jjiiaannhi3-byte/FALL-LINE/Process photos/7.jpg

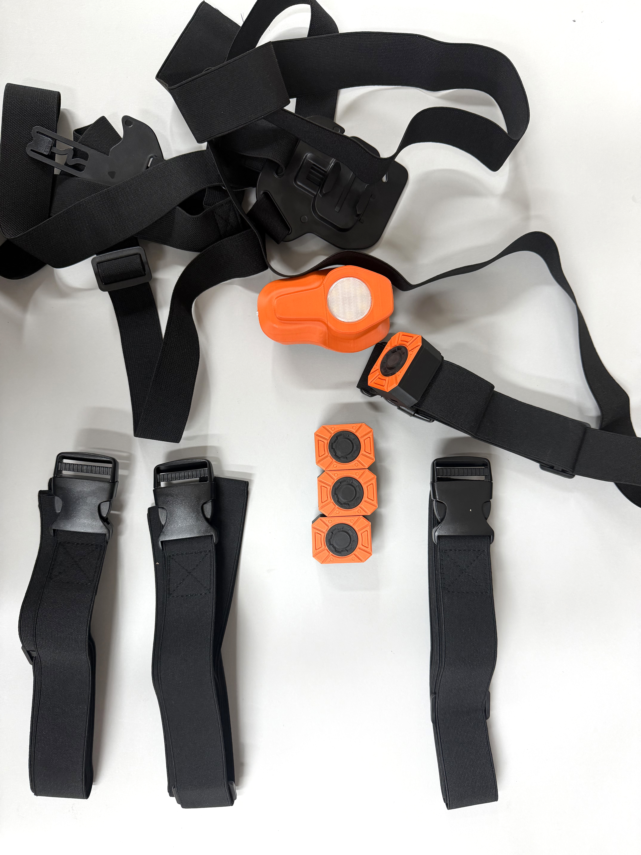
Process photos/7.jpg
