jjiiaannhi3-byte/FALL-LINE/Process photos/3.jpg

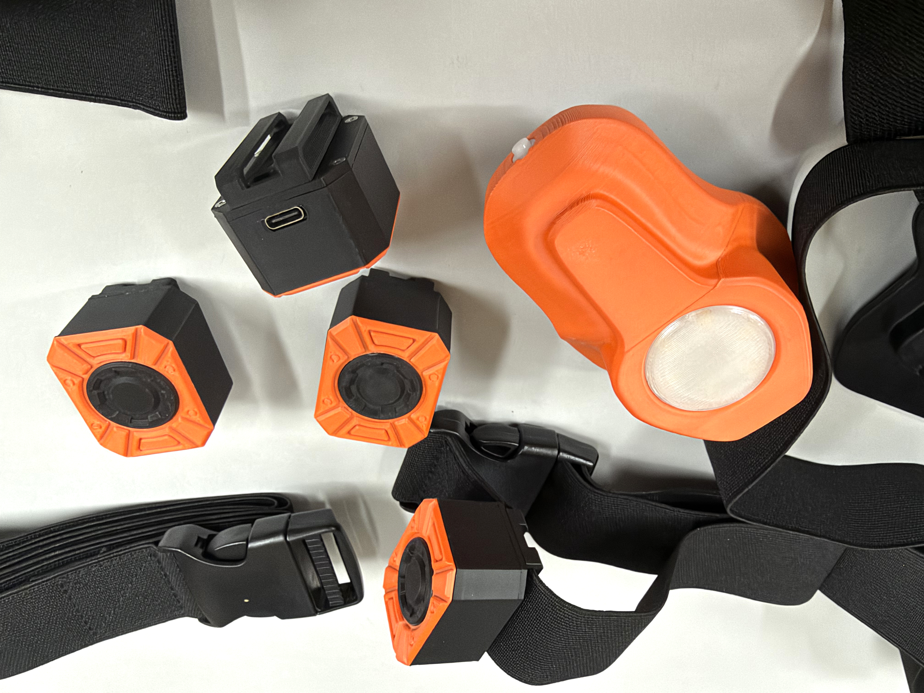
Process photos/3.jpg
