jjiiaannhi3-byte/FALL-LINE/Process photos/1.jpg

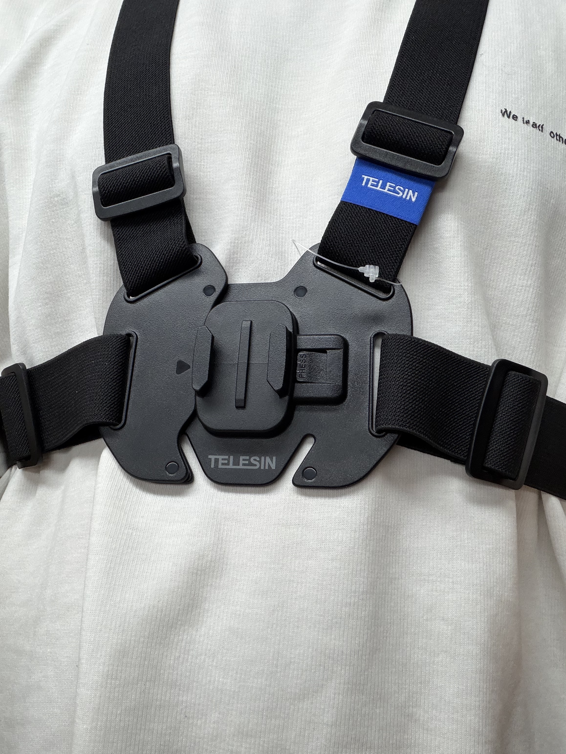
Process photos/1.jpg
