jjiiaannhi3-byte/FALL-LINE/Process photos/2.jpg

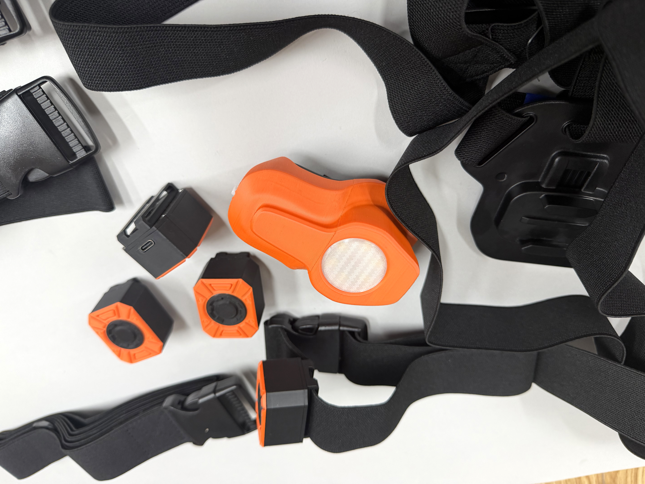
Process photos/2.jpg
