jjiiaannhi3-byte/FALL-LINE/Process photos/5.jpg

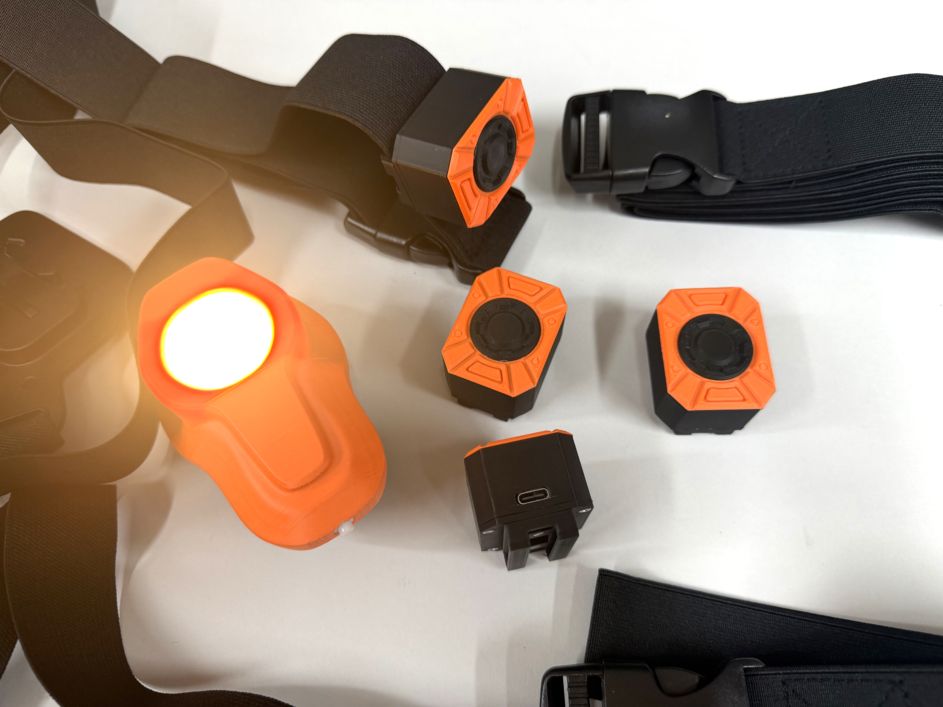
Process photos/5.jpg
