jjiiaannhi3-byte/FALL-LINE/Process photos/6.jpg

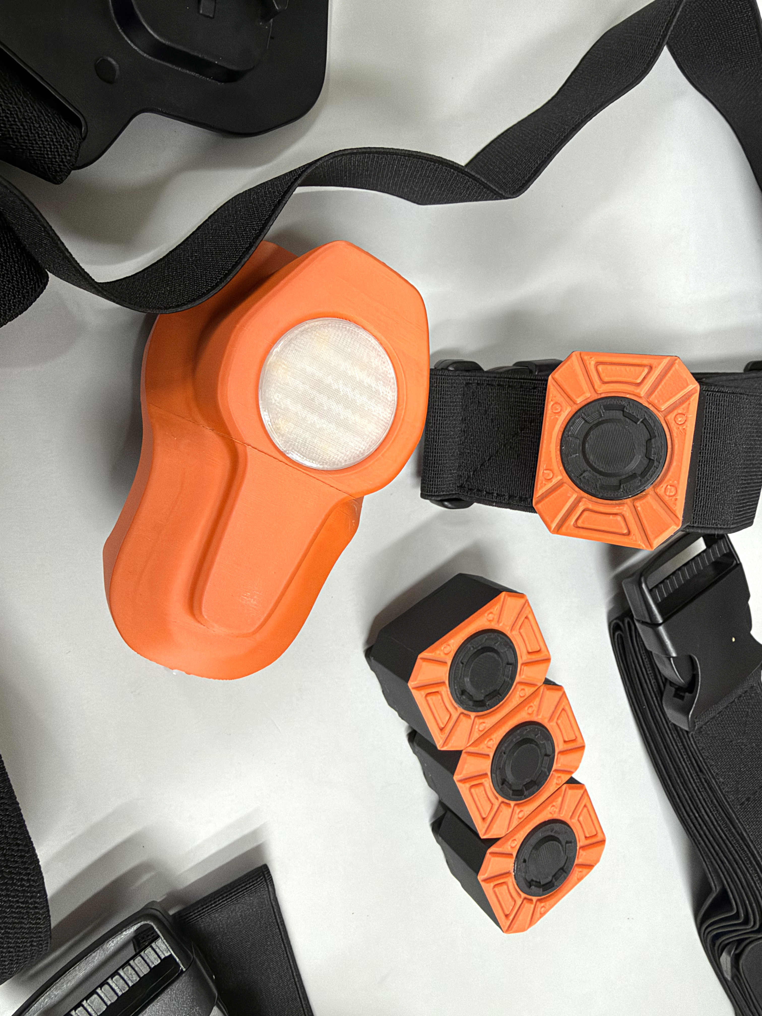
Process photos/6.jpg
