jjiiaannhi3-byte/FALL-LINE/Process photos/8.jpg

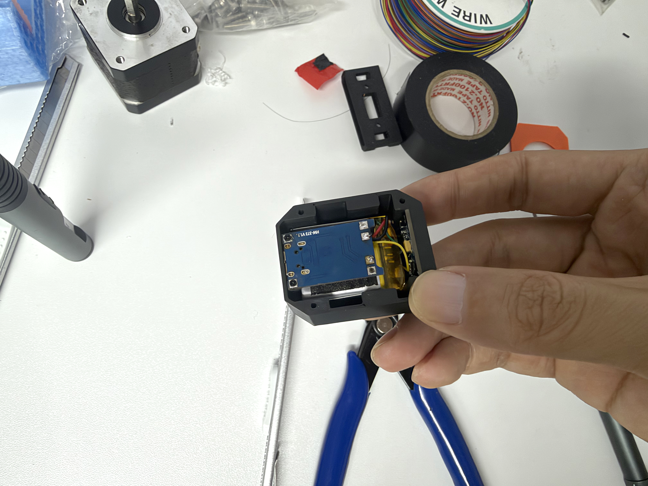
Process photos/8.jpg
