jjiiaannhi3-byte/FALL-LINE/Process photos/9.jpg

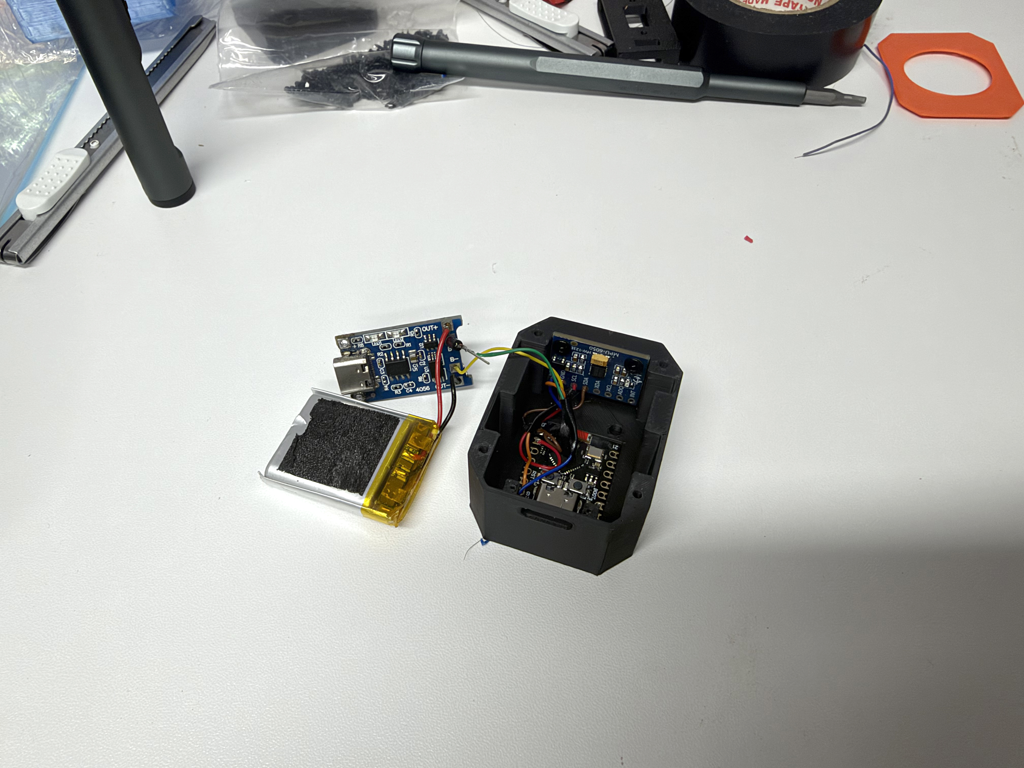
Process photos/9.jpg
