jjiiaannhi3-byte/FALL-LINE/Process photos/10.jpg

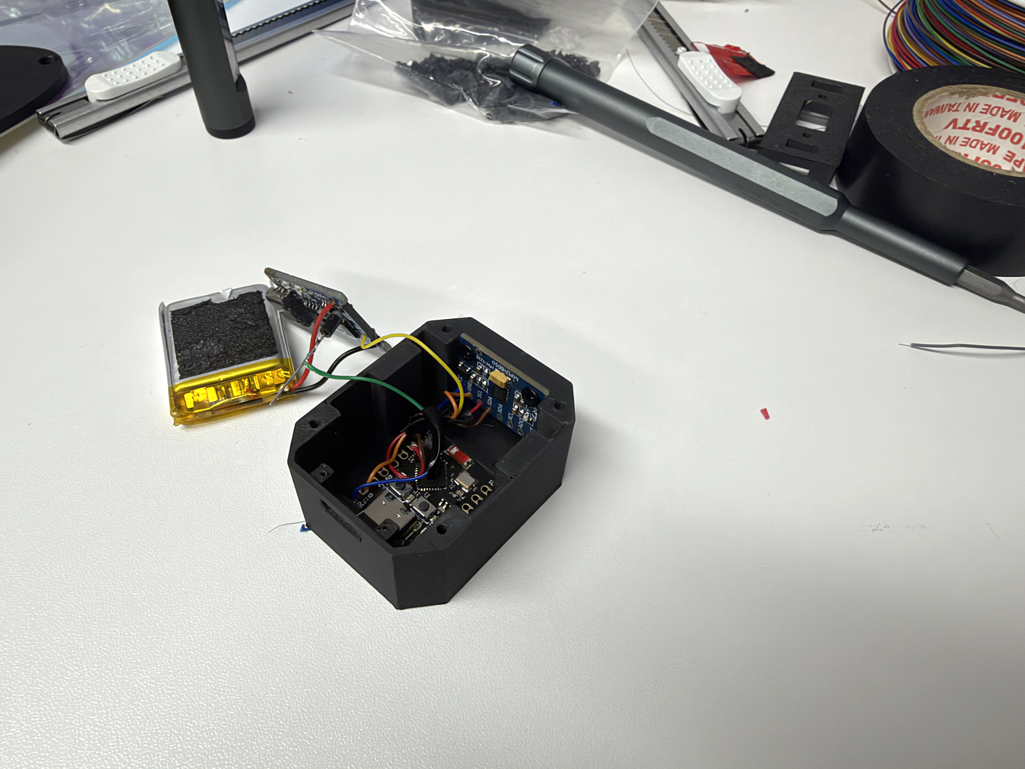
Process photos/10.jpg
