jjiiaannhi3-byte/FALL-LINE/Process photos/11.jpg

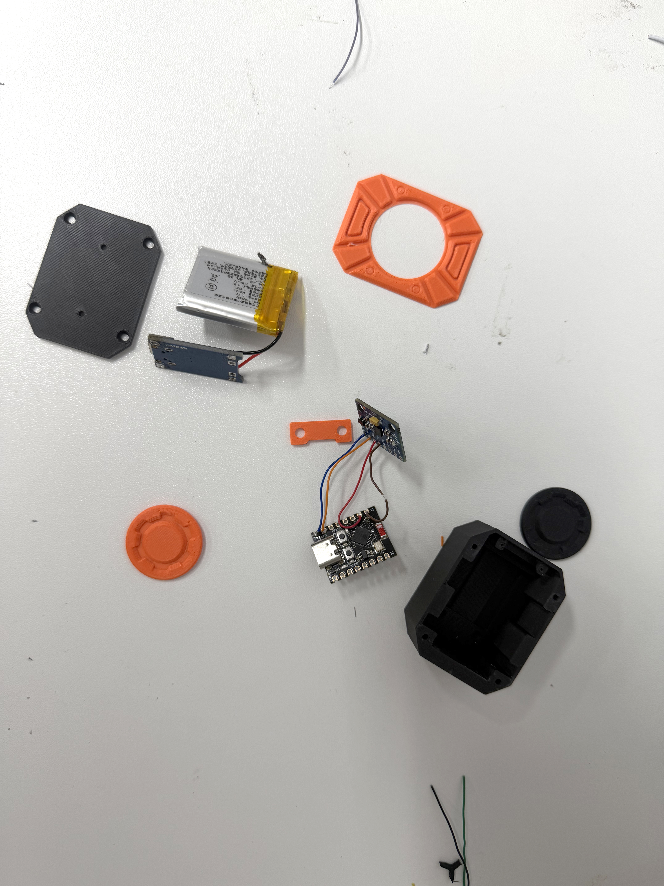
Process photos/11.jpg
