jjiiaannhi3-byte/FALL-LINE/Process photos/12.jpg

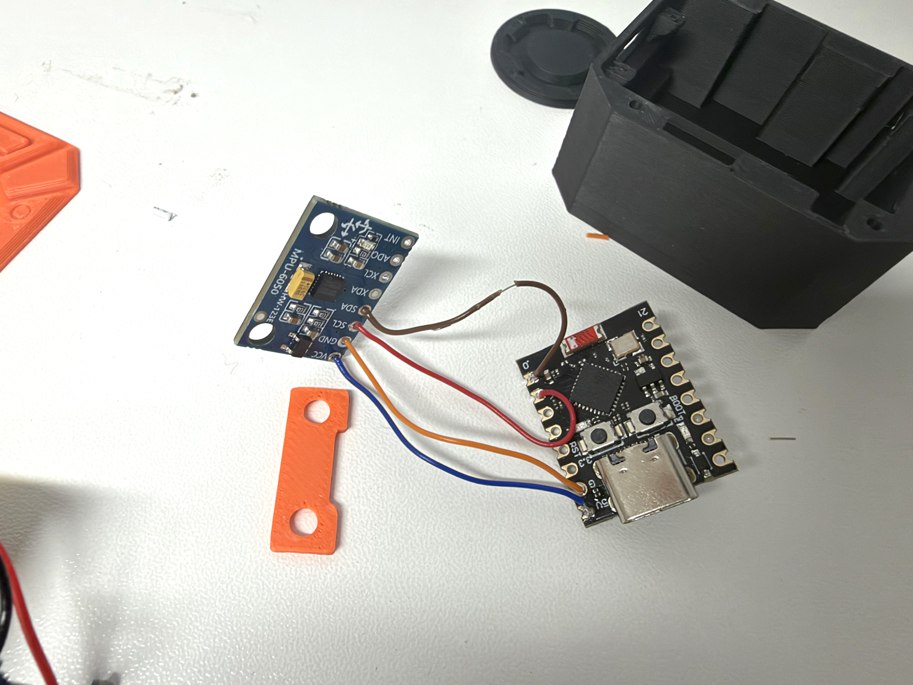
Process photos/12.jpg
