jjiiaannhi3-byte/FALL-LINE/Process photos/13.jpg

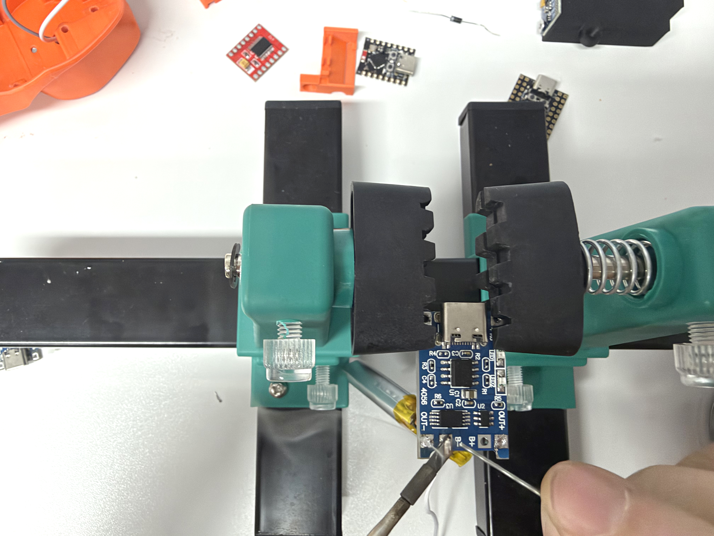
Process photos/13.jpg
