jjiiaannhi3-byte/FALL-LINE/Process photos/14.jpg

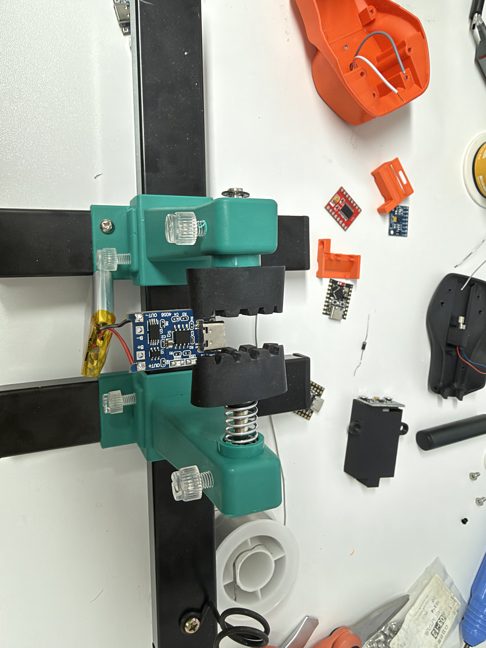
Process photos/14.jpg
