jjiiaannhi3-byte/FALL-LINE/Process photos/15.jpg

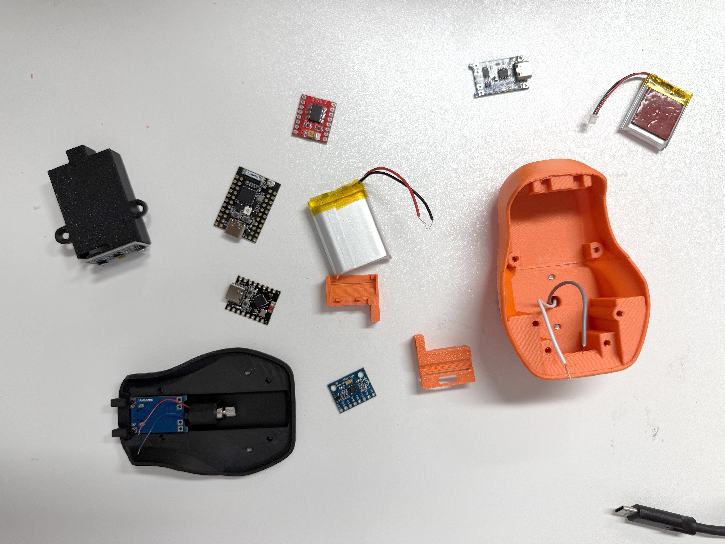
Process photos/15.jpg
