jjiiaannhi3-byte/FALL-LINE/三维建模/1.png

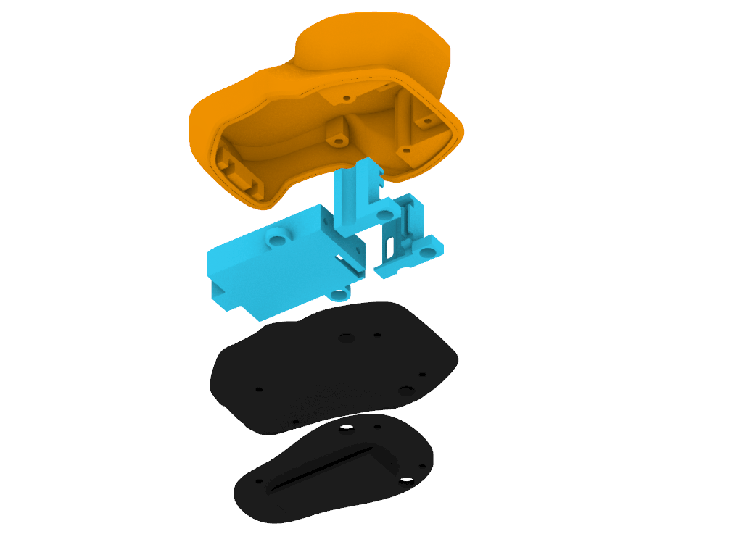
三维建模/1.png
