jjiiaannhi3-byte/FALL-LINE/三维建模/2.png

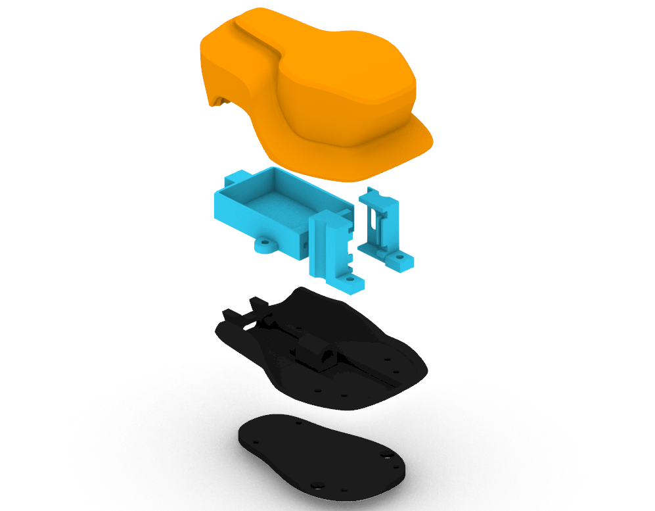
三维建模/2.png
