jjiiaannhi3-byte/FALL-LINE/三维建模/3.png

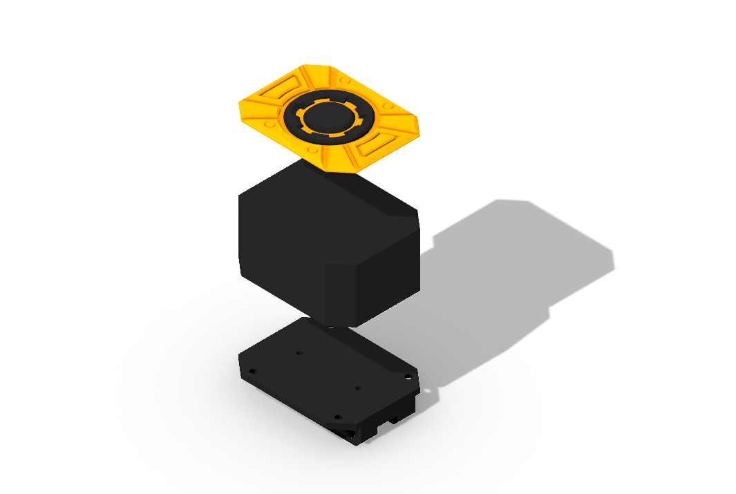
三维建模/3.png
