jjiiaannhi3-byte/FALL-LINE/三维建模/4.png

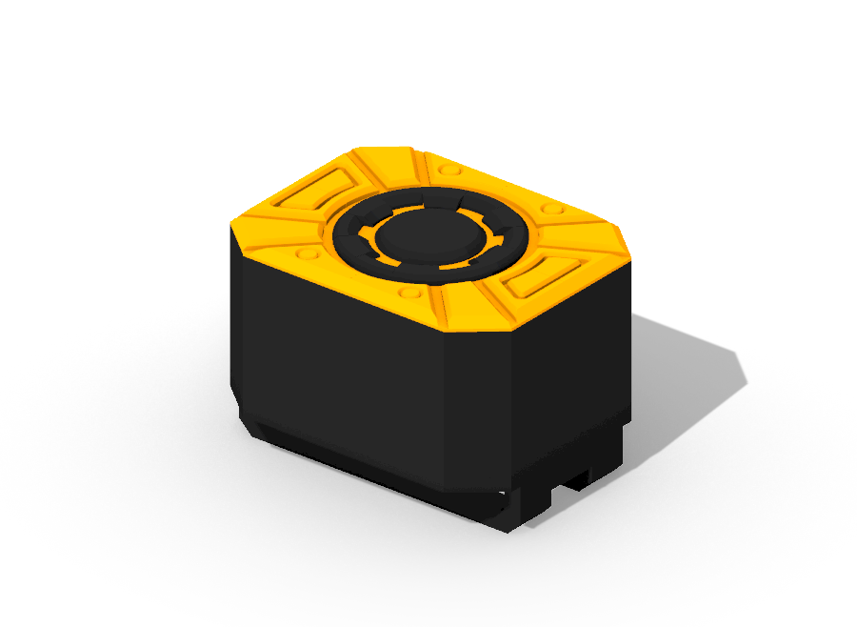
三维建模/4.png
