jjiiaannhi3-byte/FALL-LINE/三维建模/5.png

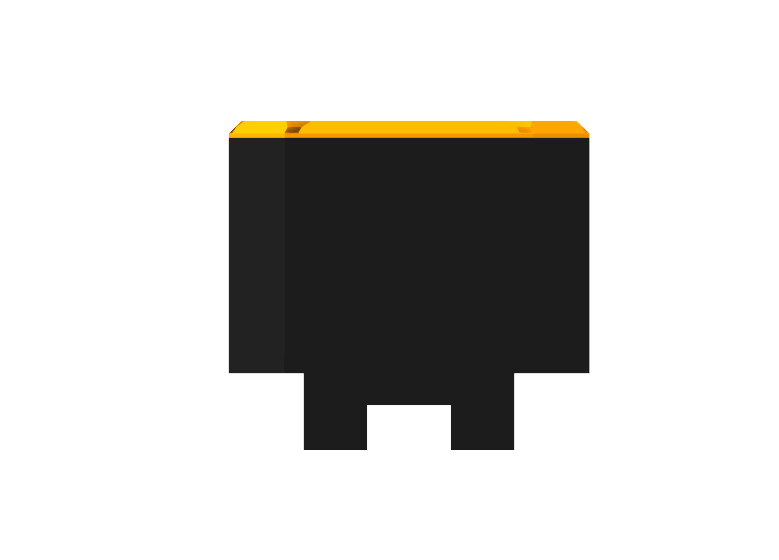
三维建模/5.png
