jjiiaannhi3-byte/FALL-LINE/三维建模/6.png

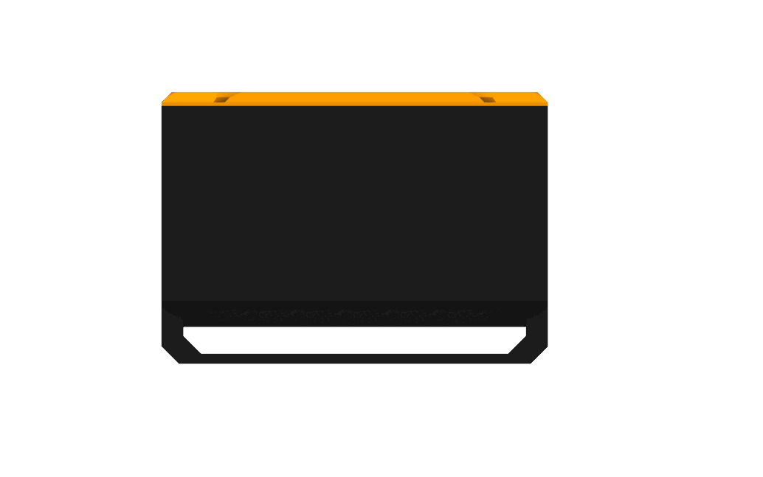
三维建模/6.png
