jjiiaannhi3-byte/FALL-LINE/三维建模/7.png

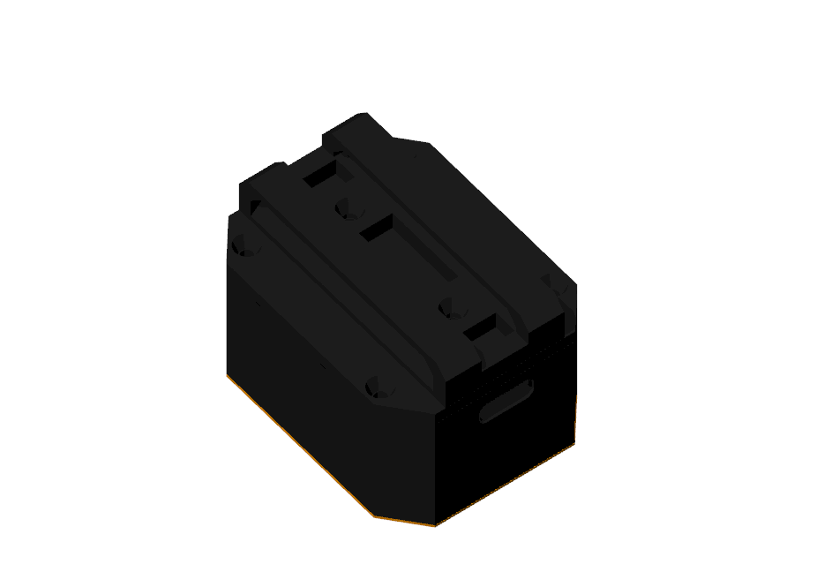
三维建模/7.png
