jjiiaannhi3-byte/FALL-LINE/三维建模/8.png

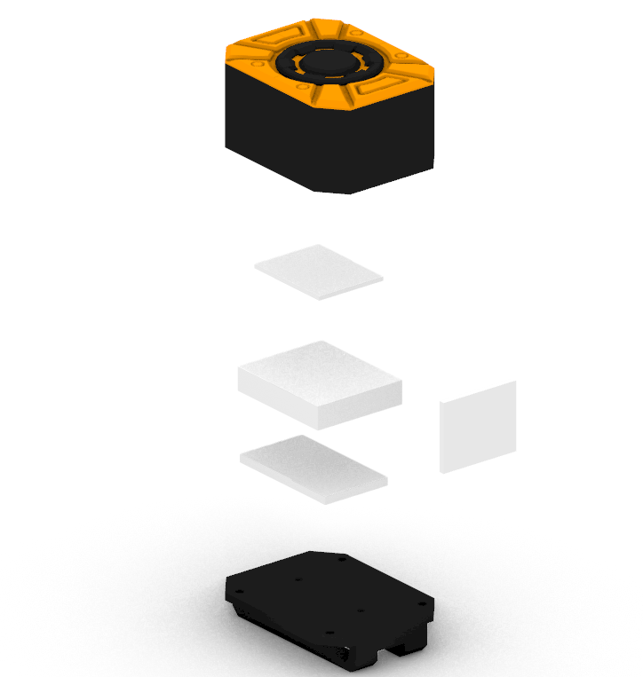
三维建模/8.png
