jjiiaannhi3-byte/FALL-LINE/三维建模/9.png

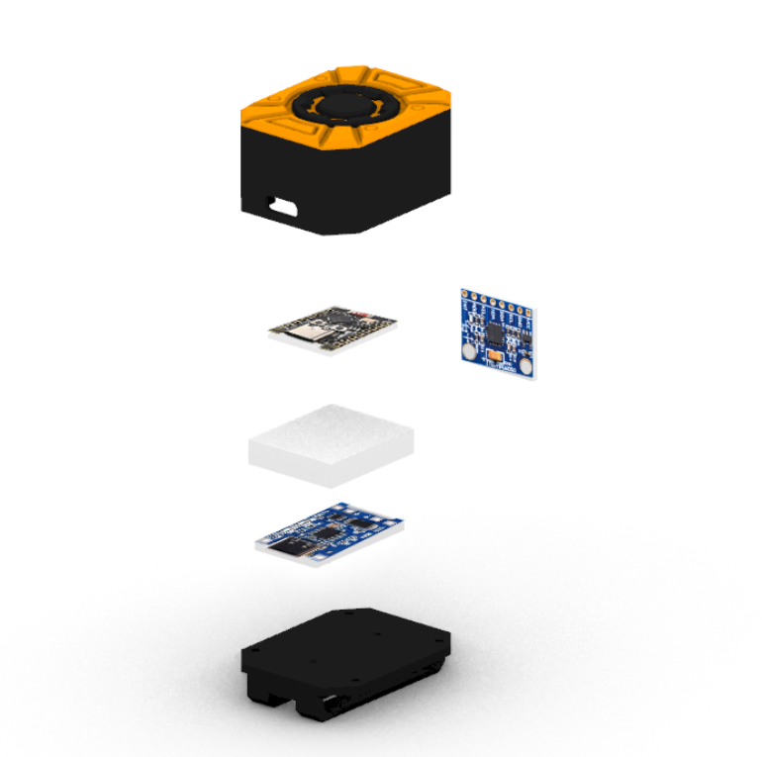
三维建模/9.png
