jjiiaannhi3-byte/FALL-LINE/三维建模/10.jpg

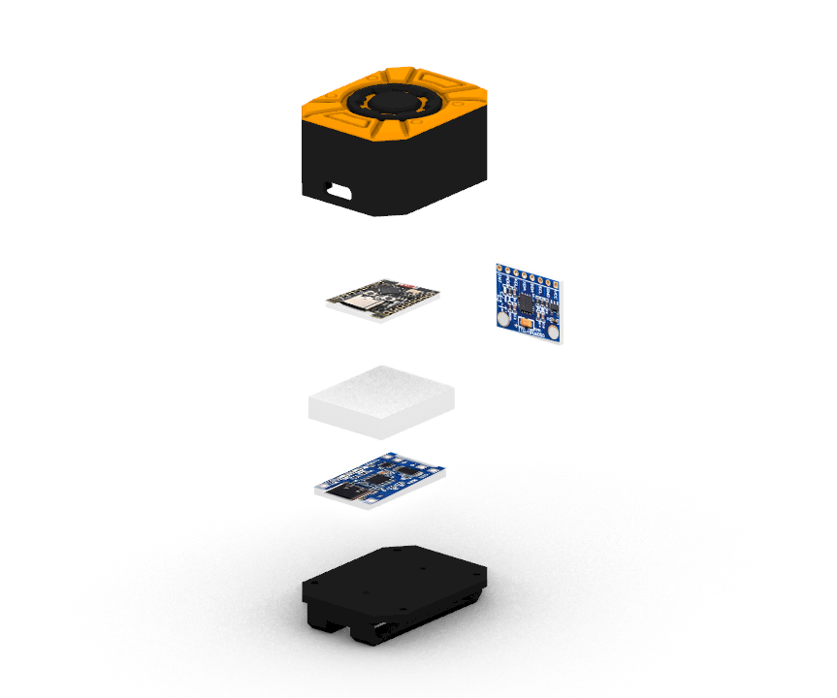
三维建模/10.jpg
