jjiiaannhi3-byte/FALL-LINE/三维建模/11.jpg

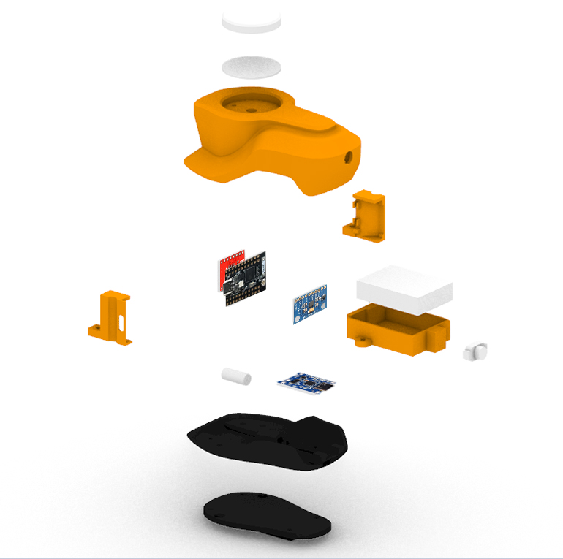
三维建模/11.jpg
