jjiiaannhi3-byte/FALL-LINE/Process photos/4.jpg

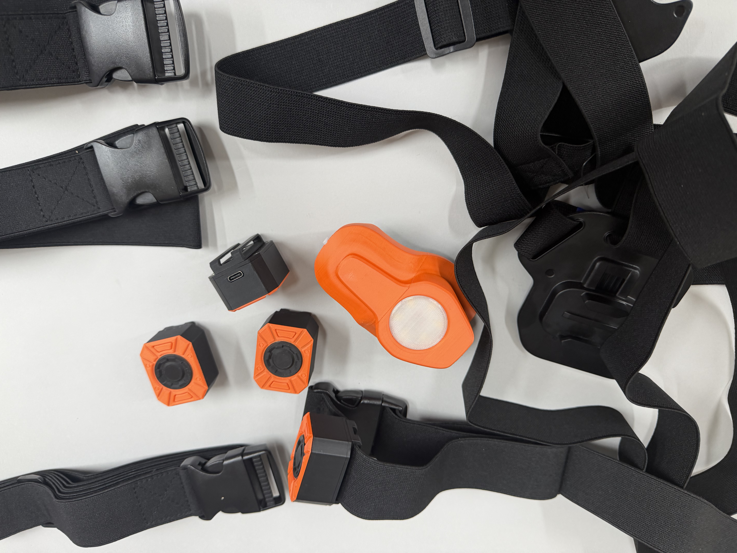
Process photos/4.jpg
